W-nova/nano-light/制作必读.pdf

### 关于模型:

提供两个版本的模型， 一个是推荐的版本，带有一个指星笔支架，支架上有凹槽，使 用时可将支架前推，凹槽会压 住指星笔开关保持常开，方便对极轴

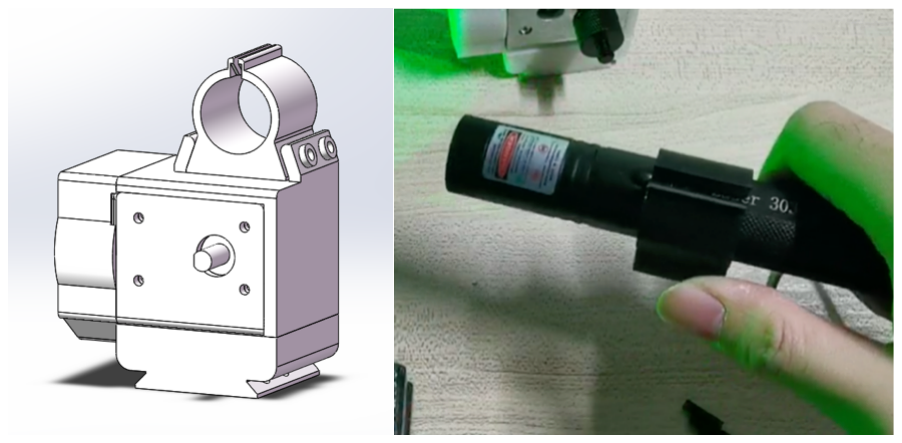
[picture p5: figure]

另一个是内置激光头的版本，但是内置激光头发热很快，成本高，制作也稍微复杂一 (亿)些， 因此不是很推荐

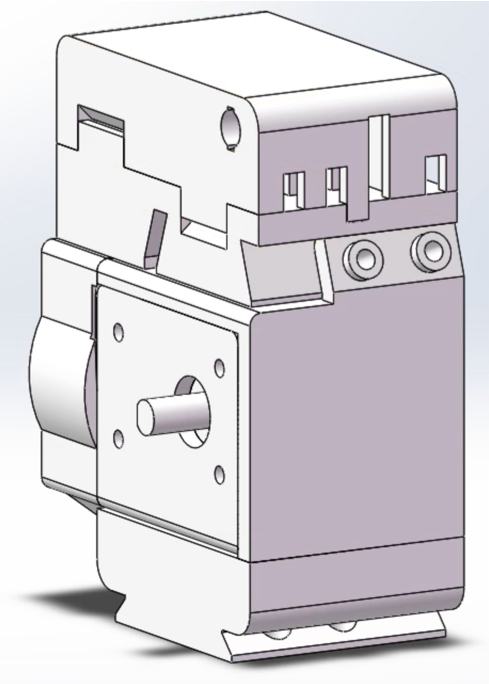
[picture p6: figure]

### 关于减速器:

*下单前记得向客服确认减速箱屁股长这样：

而不是下面这种：

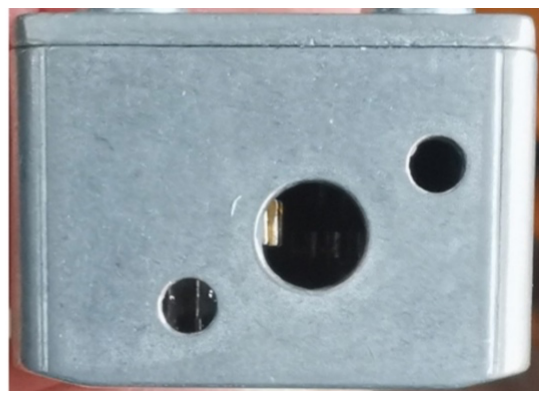
[picture p7: figure]
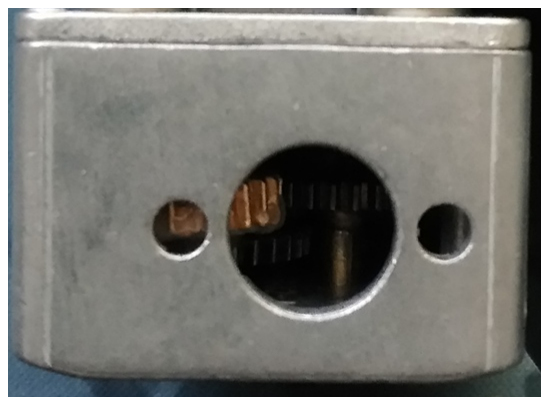
[picture p8: figure]

1:3000 减速比的减速器理论精度高一些，扭矩大一些
1:1000 减速比的减速器最快速度比 1:3000 减速比的减速器快 3 倍 可以根据自己的 需要选择。
1:1000 减速比的减速器是现成的(抽油烟机专用 JGY-370 减速器，带 M5 螺纹) 1:3000 减速比的减速器需要叫卖家更换减速器的输出轴，就说更换成抽油烟机专用， 带 M5 螺纹的那个，卖家大概就懂了

*有的朋友自制时反应了个情况:买到的 1:3000 减速比的减速器的孔中，黄色齿轮偏离 的厉害，接触不到蜗杆。

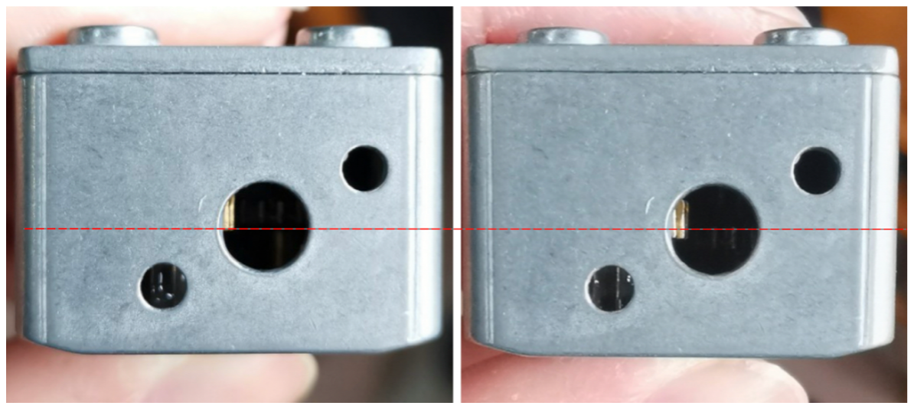
[picture p9: figure]

左:黄铜齿轮偏得厉害，在中线之上了 右:正确的黄铜齿轮正确的位置

这是因为卖家更换减速器的输出轴时，把下图两个垫环放反了......

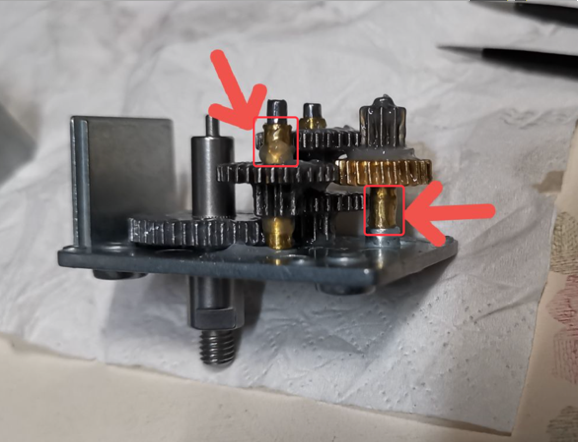
[picture p10: figure]
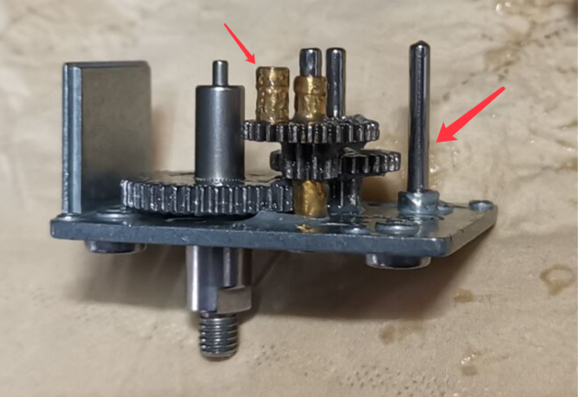
[picture p11: figure]

可以看出，这两个垫环有一点高度差别，将高一些的在放在箭头所指的轴上，就可以 解决这 个问题。

步进电机一定叫买家取下齿轮再发货

模型使用 PLA 材料打印即可，填充率 40%以上就行，3D 打印价格大家就各凭本事 了，运气 好首单免费，不过一般也在 50 以下。
