W-nova/nano-light/维度调节座/安装说明.pdf

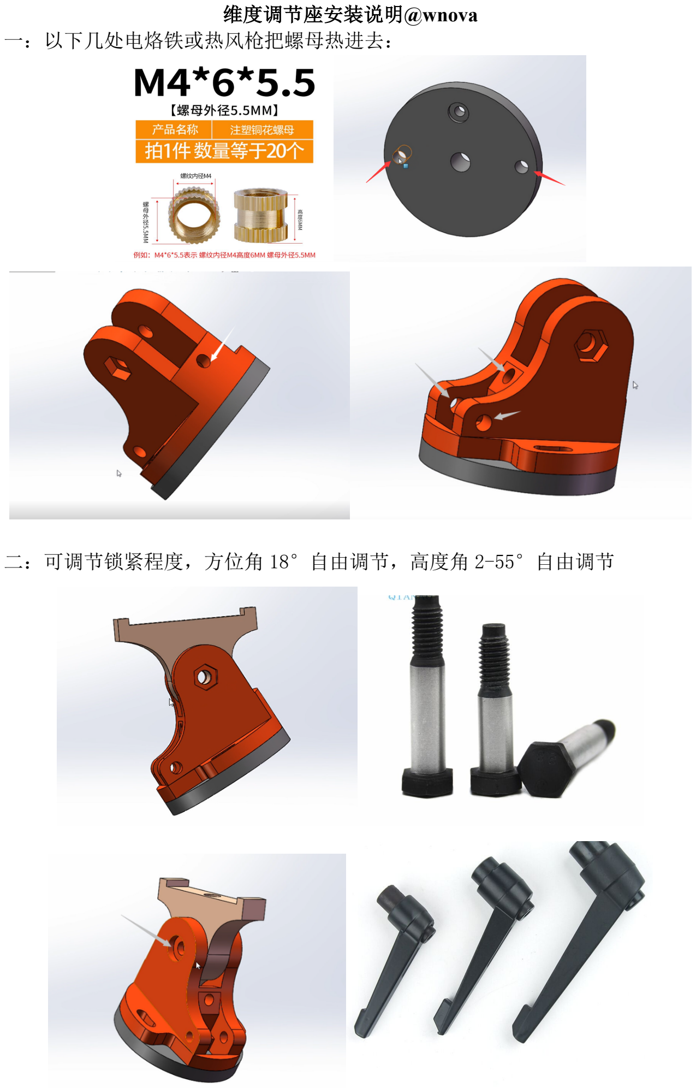
[picture p12: page 1]

维度调节座安装说明@wnova
一：以下几处电烙铁或热风枪把螺母热进去：

二：可调节锁紧程度，方位角 18°自由调节，高度角 2-55°自由调节

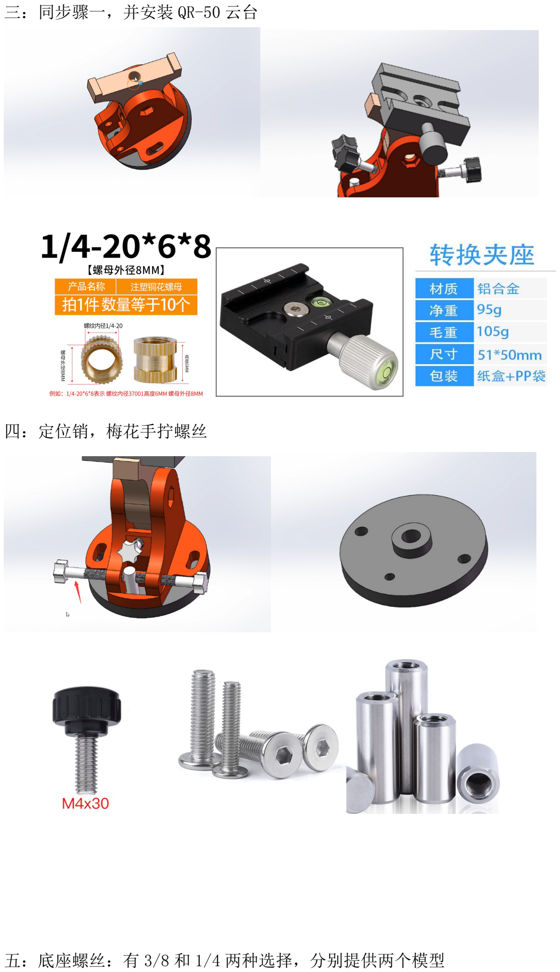
[picture p13: page 2]

三：同步骤一，并安装 QR-50 云台

四：定位销，梅花手拧螺丝

五：底座螺丝：有 3/8 和 1/4 两种选择，分别提供两个模型

1/4 需注塑，安装同步骤一，喜欢金属可靠感+脚架支持 1/4 螺纹的可选

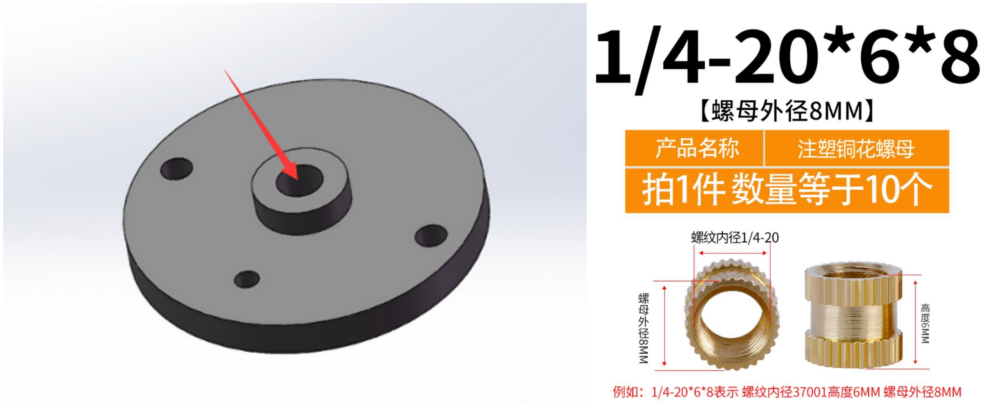
[picture p14: figure]

3/8 自带螺纹，可以直接打印，适用范围广，螺纹更大更稳定，可转接 1/4 螺 纹，使用时间长可能会磨损

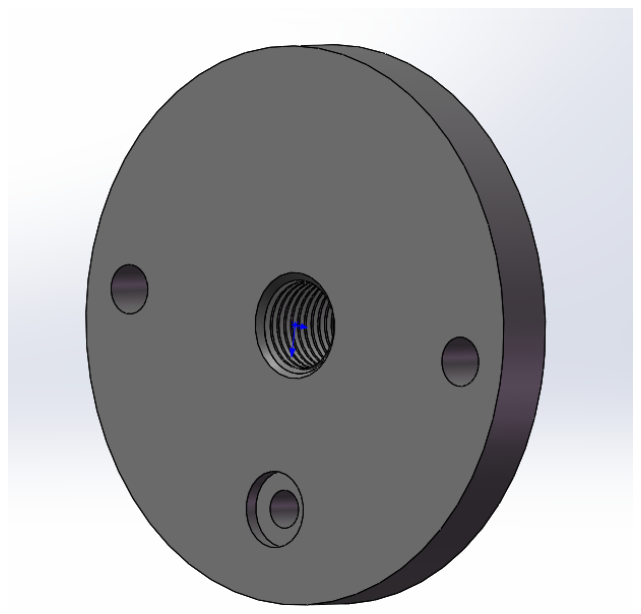
[picture p15: figure]
