W-nova/nano-light/3D Model/使用指星笔版(推荐)/接线.jpg

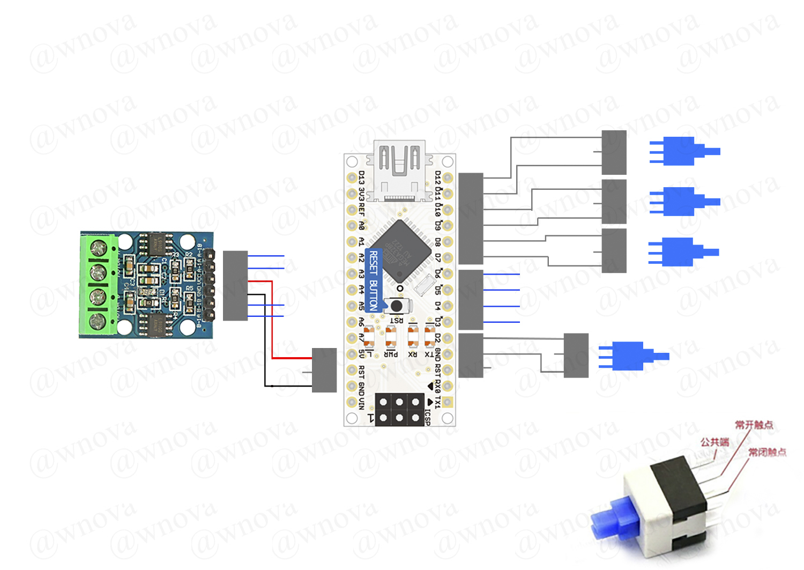
3D Model/使用指星笔版(推荐)/接线.jpg
