W-nova/nano-light/3D Model/内置激光器版/接线laser.jpg

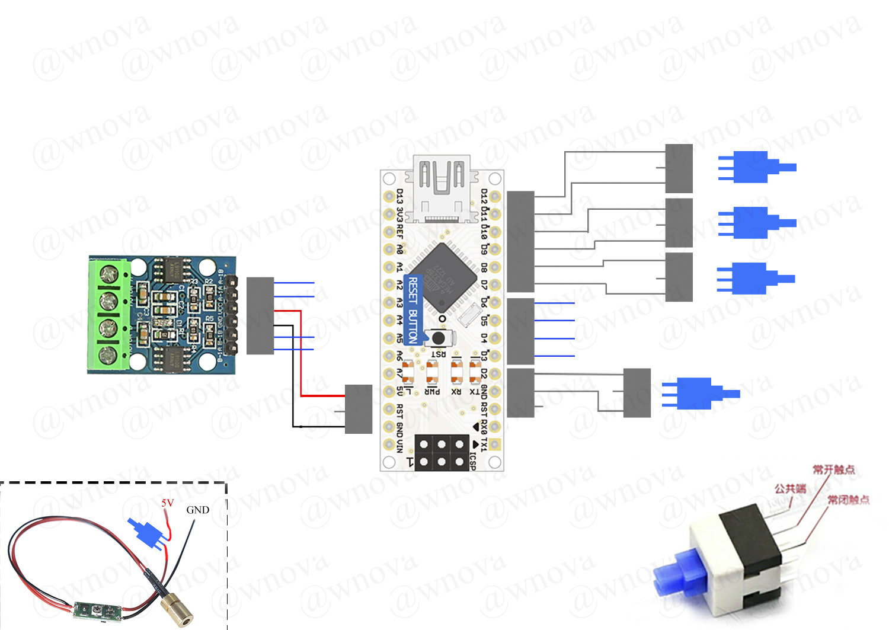
3D Model/内置激光器版/接线laser.jpg
