W-nova/nano-light/3D Model/内置激光器版/激光头.jpg

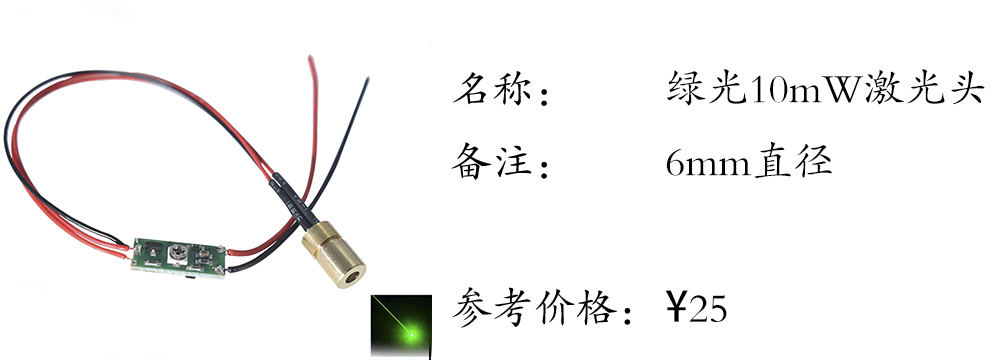
3D Model/内置激光器版/激光头.jpg
