W-nova/nano-light/Code/速度表.png

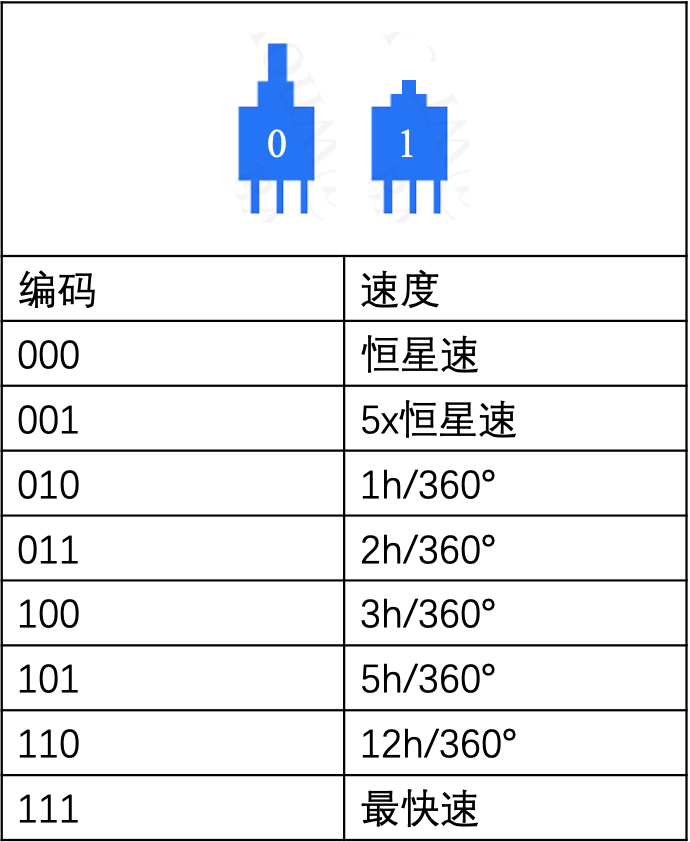
Code/速度表.png
