W-nova/nano-light/维度调节座/店铺参考_请根据实际灵活调整.jpg

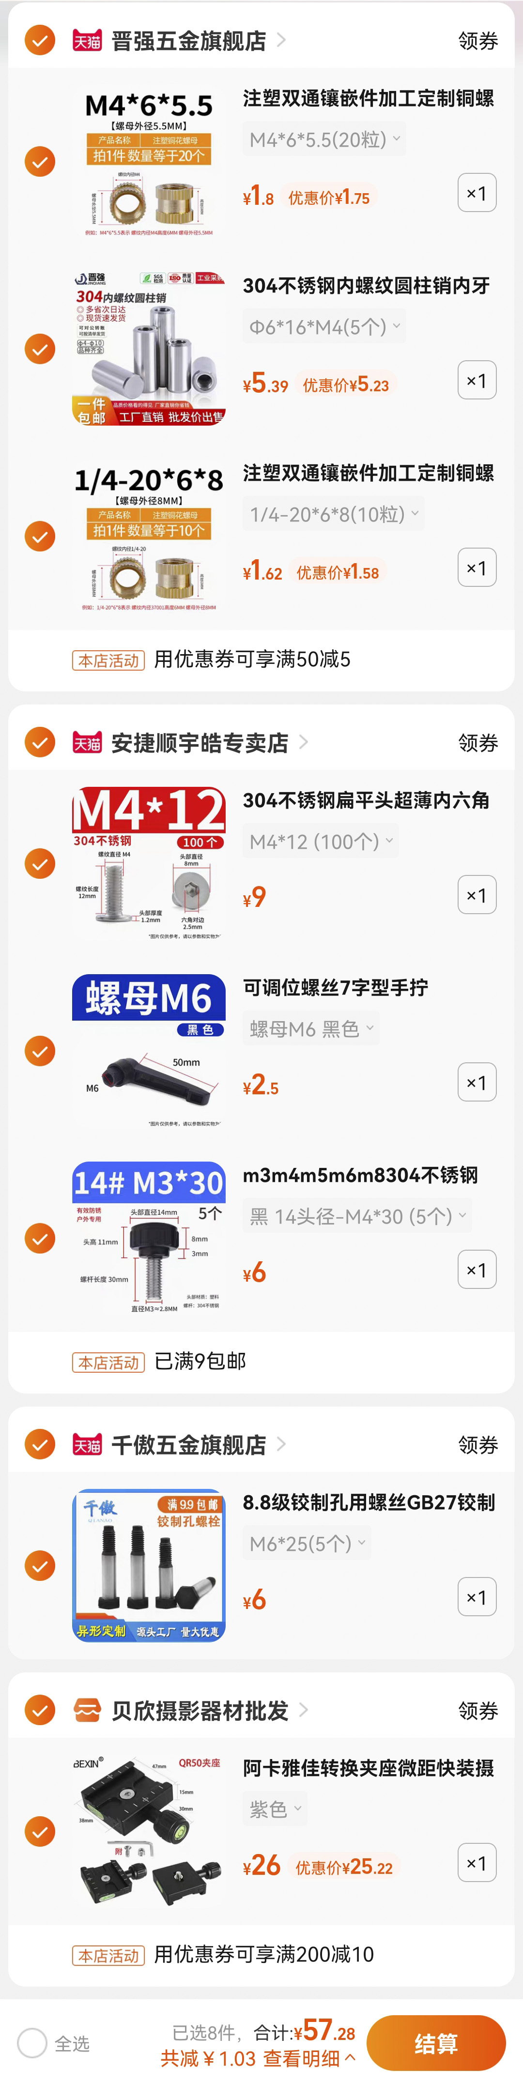
维度调节座/店铺参考_请根据实际灵活调整.jpg
