W-nova/nano-light/物料表/工具.jpg

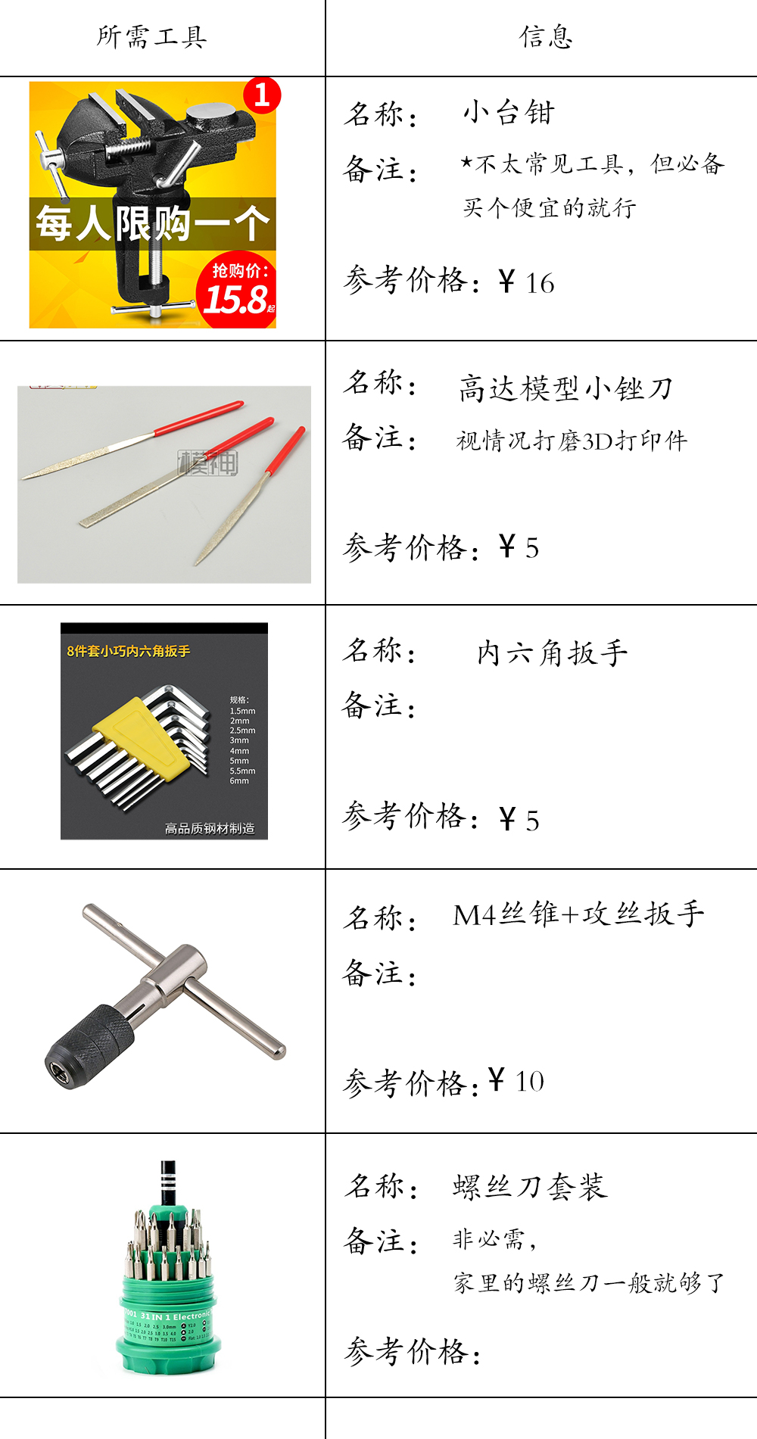
物料表/工具.jpg
