W-nova/nano-light/物料表/机械部分.jpg

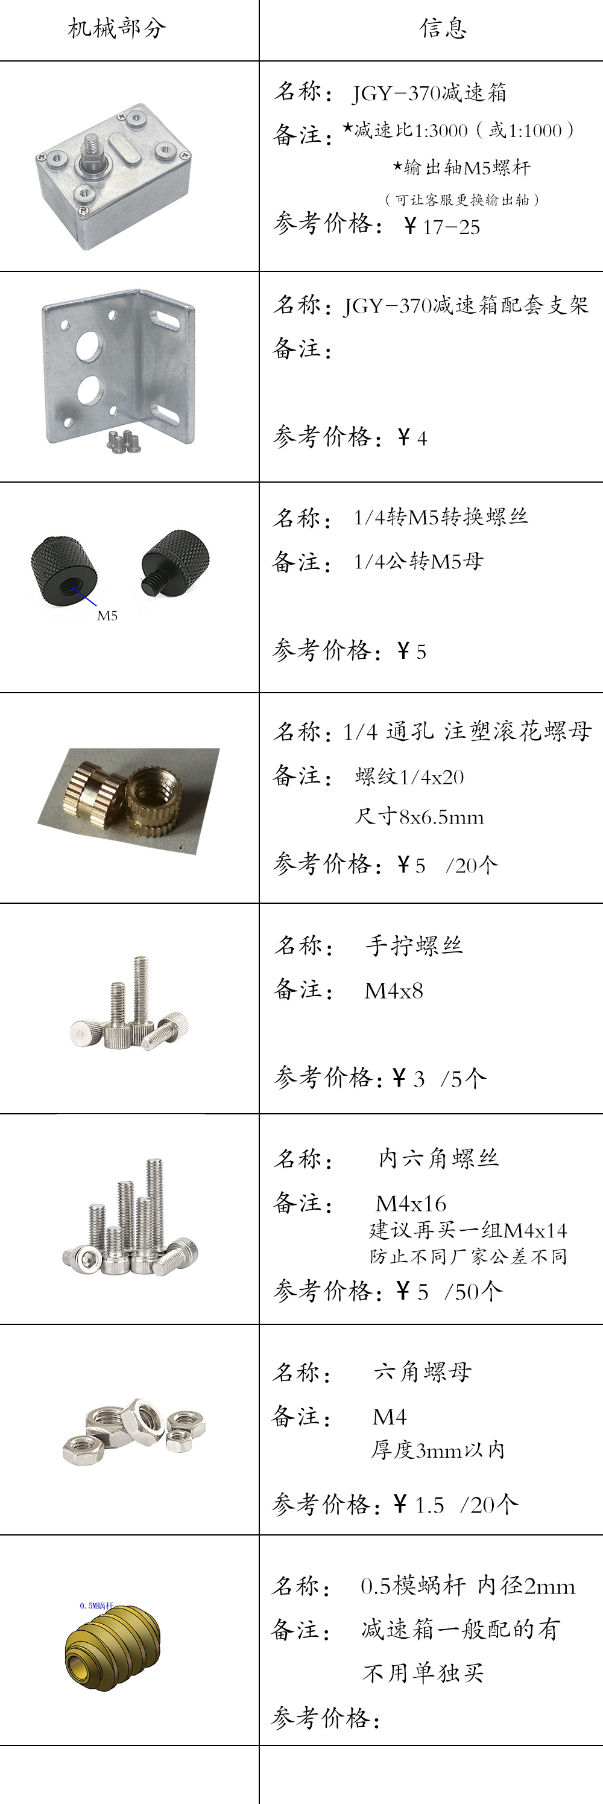
物料表/机械部分.jpg
