W-nova/nano-light/物料表/电子部分.jpg

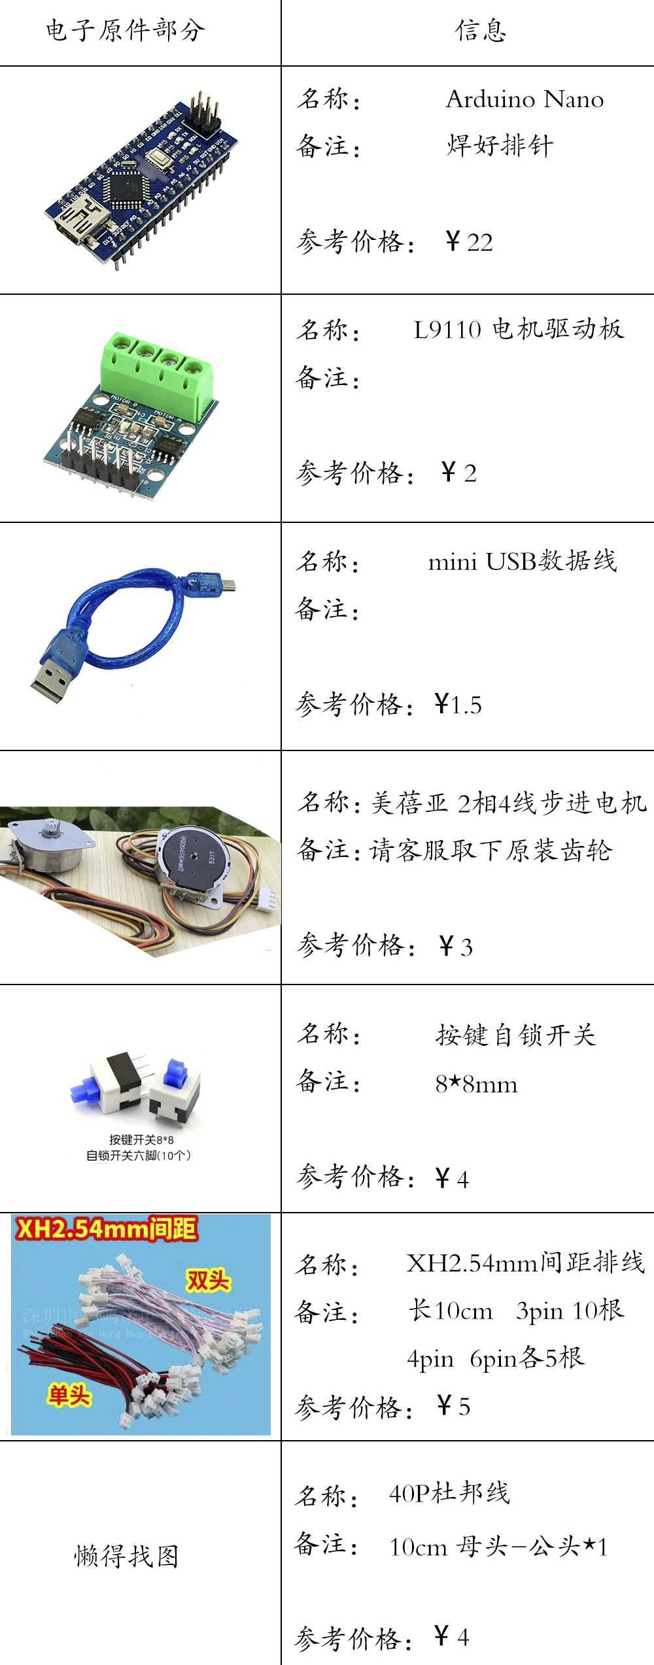
物料表/电子部分.jpg
