W-nova/nano-light/3D Model/使用指星笔版(推荐)/手控1.STL

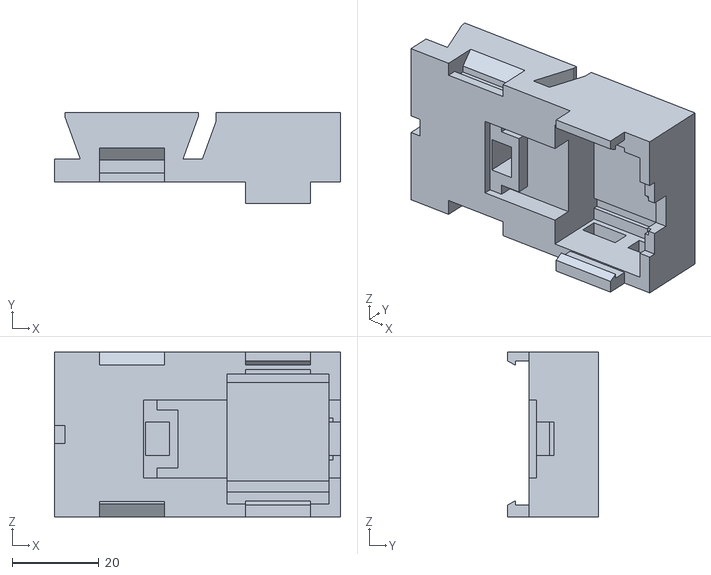
[picture p37: CAD file, 2021-12-29]
3D Model/使用指星笔版(推荐)/手控1.STL
66.0 x 21.0 x 38.0
