W-nova/nano-light/3D Model/内置激光器版/手控2_laser.STL

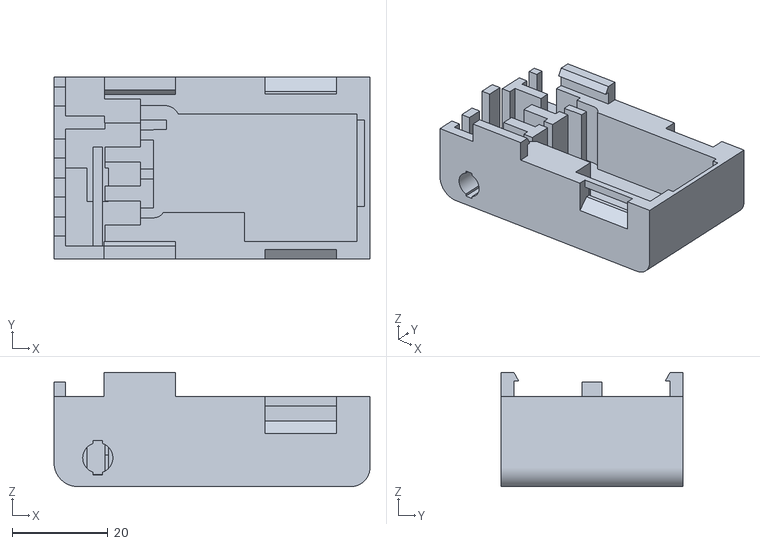
[picture p38: CAD file, 2022-01-10]
3D Model/内置激光器版/手控2_laser.STL
66.0 x 38.0 x 23.9
