W-nova/nano-light/维度调节座/STL3D打印文件/底座_注塑1_4螺母.STL

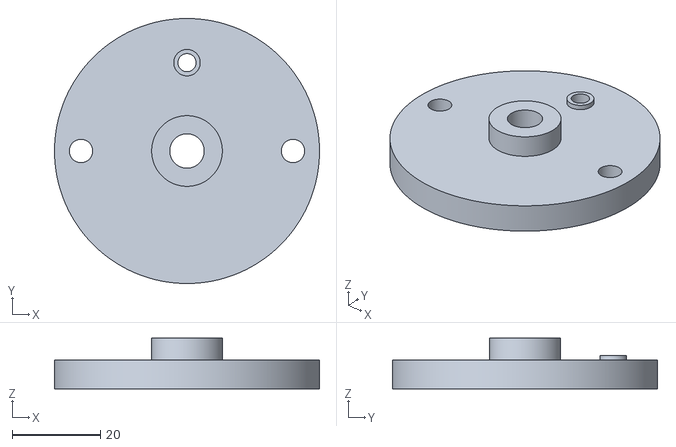
[picture p39: CAD file, 2022-02-22]
维度调节座/STL3D打印文件/底座_注塑1_4螺母.STL
60.0 x 60.0 x 11.5
