W-nova/nano-light/3D Model/使用指星笔版(推荐)/手控2.STL

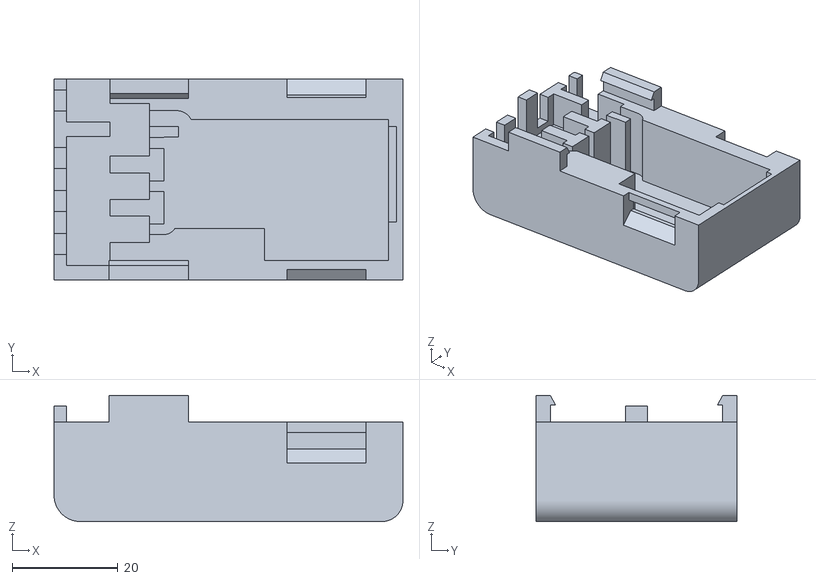
[picture p40: CAD file, 2021-12-27]
3D Model/使用指星笔版(推荐)/手控2.STL
66.0 x 38.0 x 23.9
