W-nova/nano-light/维度调节座/STL3D打印文件/俯仰座.STL

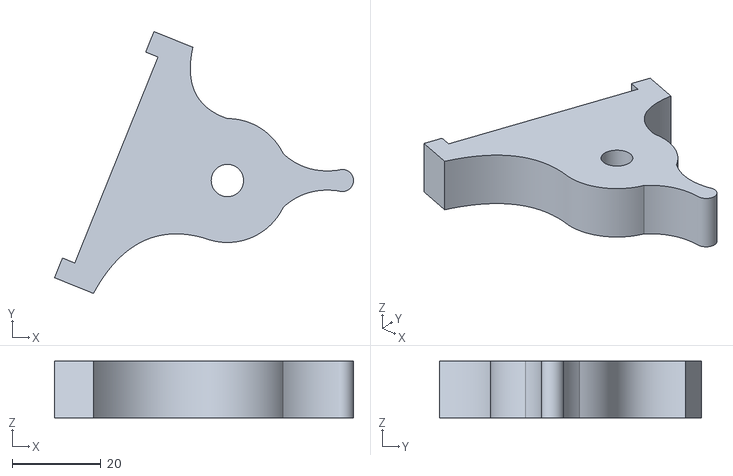
[picture p41: CAD file, 2022-02-22]
维度调节座/STL3D打印文件/俯仰座.STL
67.6 x 59.2 x 12.8
