W-nova/nano-light/3D Model/使用指星笔版(推荐)/指星笔支架.STL

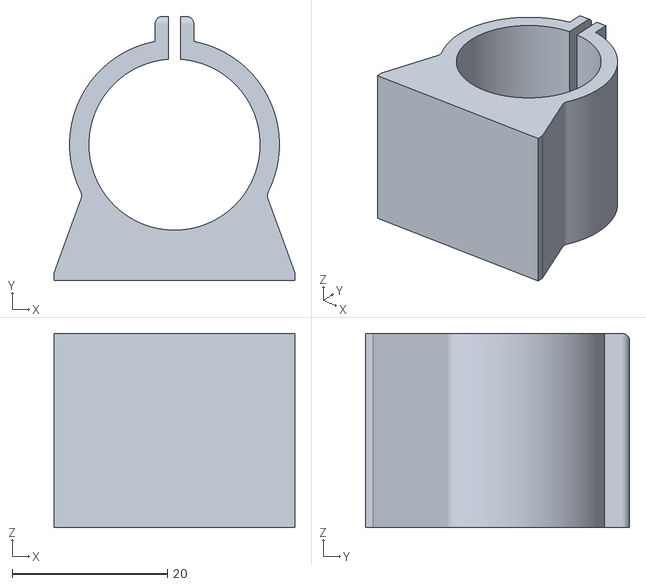
[picture p42: CAD file, 2021-12-25]
3D Model/使用指星笔版(推荐)/指星笔支架.STL
31.0 x 34.0 x 25.0
