W-nova/nano-light/3D Model/内置激光器版/步进电机外壳.STL

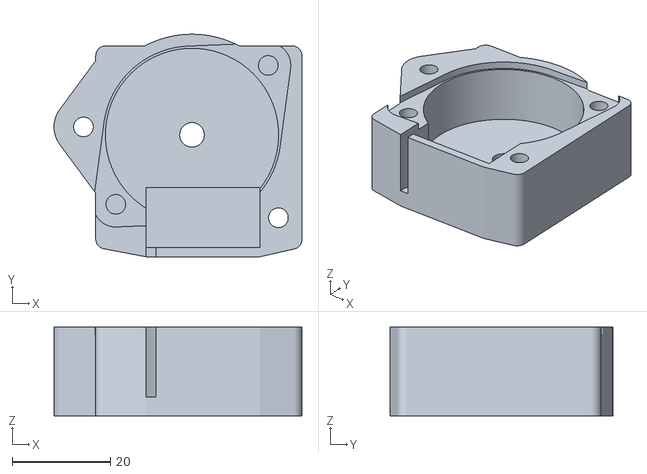
[picture p43: CAD file, 2021-12-25]
3D Model/内置激光器版/步进电机外壳.STL
50.5 x 45.3 x 18.1
