W-nova/nano-light/维度调节座/STL3D打印文件/俯仰座_加宽.STL

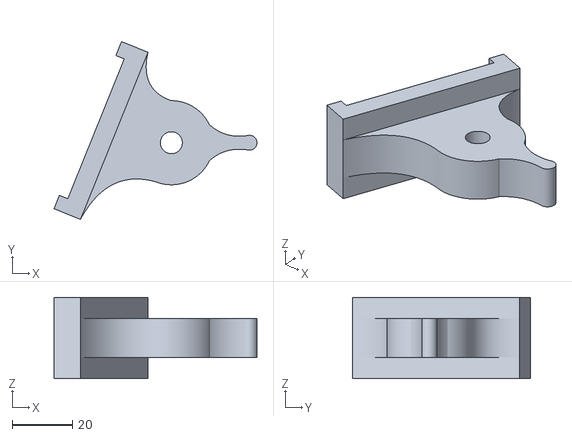
[picture p44: CAD file, 2022-02-22]
维度调节座/STL3D打印文件/俯仰座_加宽.STL
67.6 x 59.2 x 27.0
