W-nova/nano-light/3D Model/使用指星笔版(推荐)/减速器外壳.STL

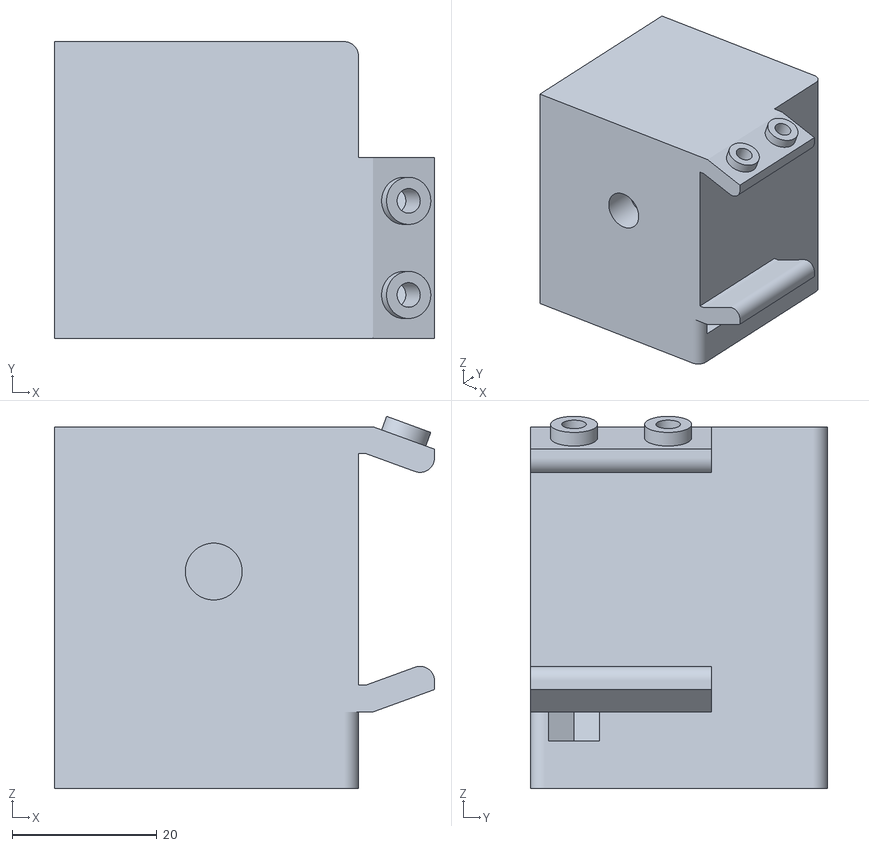
[picture p45: CAD file, 2021-12-25]
3D Model/使用指星笔版(推荐)/减速器外壳.STL
52.5 x 41.0 x 51.4
