W-nova/nano-light/维度调节座/STL3D打印文件/支架.STL

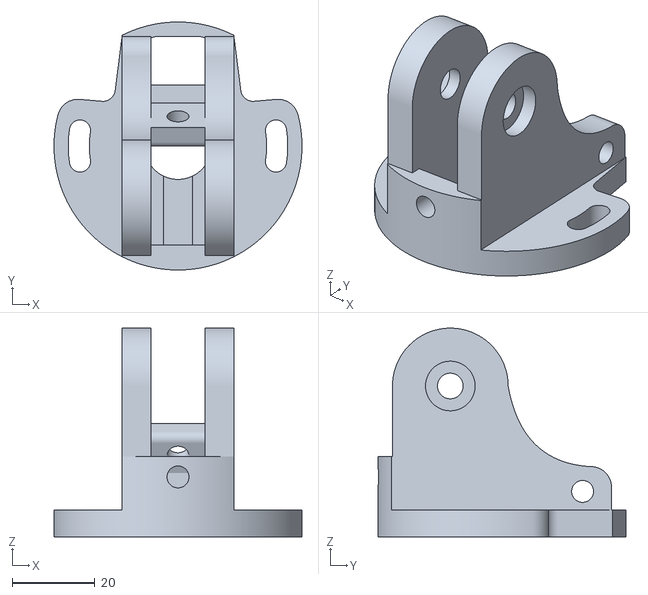
[picture p46: CAD file, 2022-02-22]
维度调节座/STL3D打印文件/支架.STL
60.0 x 60.0 x 50.5
