W-nova/nano-light/3D Model/使用指星笔版(推荐)/底座.STL

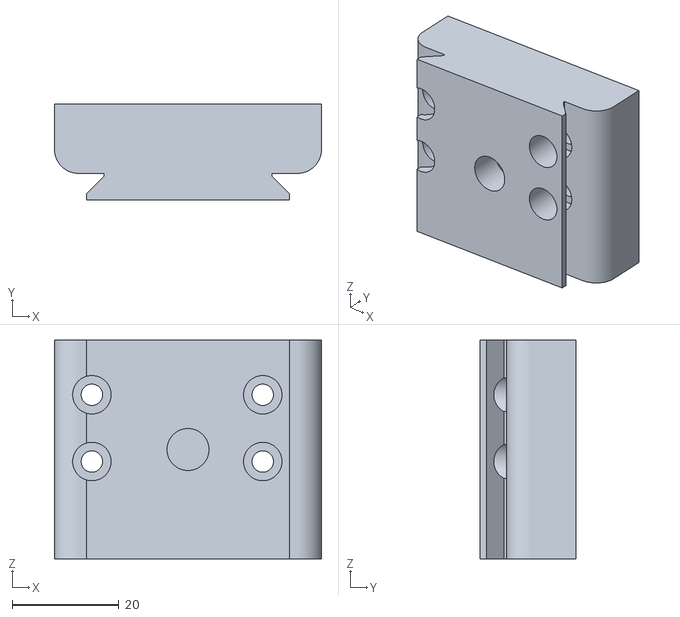
[picture p47: CAD file, 2021-12-25]
3D Model/使用指星笔版(推荐)/底座.STL
50.0 x 18.0 x 41.0
