W-nova/nano-light/3D Model/内置激光器版/固定片.STL

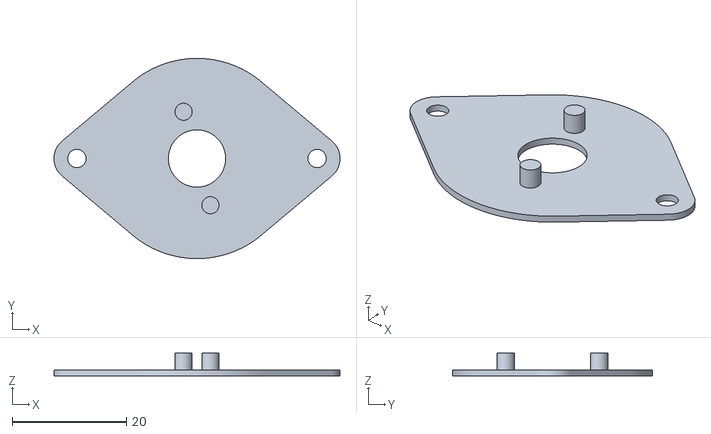
[picture p49: CAD file, 2021-11-27]
3D Model/内置激光器版/固定片.STL
50.0 x 35.0 x 4.00
