W-nova/nano-light/(commit log)

2021-11-27 删除文件 README.en.md
2021-11-27 新建 3D Model
2021-11-27 新建 Code
2021-11-27 3D stl file - equatorial mount part 赤道仪本体部分Stl文件
    [固定片.stl, 外壳1.STL, 外壳2.STL, 外壳底座.STL]
2021-11-27 新建 picture
2021-11-28 删除文件 Code/tracker_1000_v4/tracker_1000_v4.ino
2021-11-28 删除文件 Code/tracker_3000_v4
2021-11-28 修复延时速度
2021-12-25 final version
    [减速器外壳.STL, 固定片.STL, 外壳1.STL, 外壳2.STL, 外壳底座.STL, 底座.STL, 手控1.STL, 手控2.STL]
2021-12-27 new ctl slt
    [手控2.STL, 手控2_laser.STL]
2021-12-29 opt gap
    [手控1.STL]
2022-01-10 opt laser_ctl
    [手控2_laser.STL]
2022-01-17 opt circuit
2022-01-23 opt circuit connect
2022-02-14 删除文件 维度调节座/模型文件.rar
